polymel/chauffez-les-BEES-/Simon perso/Photos_Simon/montage carte, avec masque.jpg

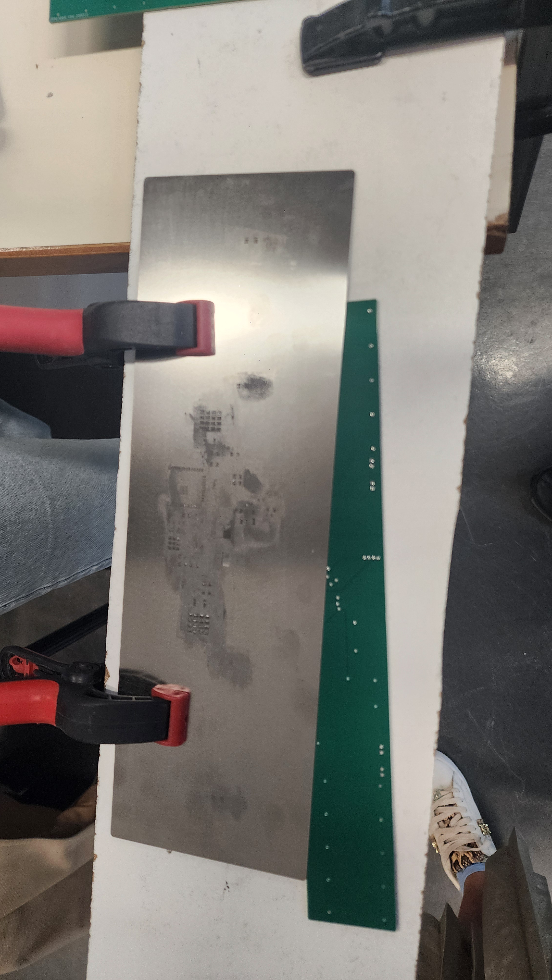
Simon perso/Photos_Simon/montage carte, avec masque.jpg
