polymel/chauffez-les-BEES-/Melilla perso/Montage téleversement.jpg

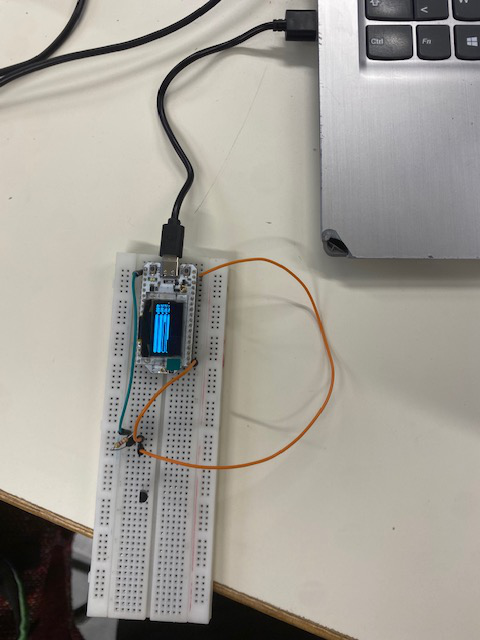
Melilla perso/Montage téleversement.jpg
