polymel/chauffez-les-BEES-/README.md

Ce reposit permet de regrouper les informations autour du projet d'électonique: réchauffement de ruche
consistant à réchauffer une ruche avec un stockage d'énergie thermique et un système électronique directement alimenté par un panneau solaire sans batterie
