polymel/chauffez-les-BEES-/Laura perso/Cahier de bord Projet Elec.pdf

Laura Boivin | ELSE4 23/09/2024

Cahier de bord

Où nous en étions :
La séance dernière nous avons étudié les objectifs du projet à travers la réalisation du cahier des charges (les destinataires du projet, les utilités, les contraintes du projet, coûts, les délais etc.). Projet qui s’étalera sur 9 mois comprenant des séances de 4h. Ce que nous avons fait cette séance :
Création du schéma électrique :

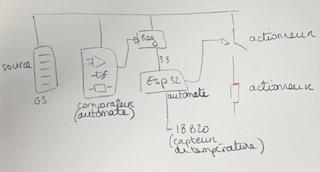
[picture p32: figure]

On a déterminé les différents composants nécessaires : une source d'énergie (un panneau solaire et un régulateur), un actionneur (résistances qui chauffent un interrupteur), un automate (ESP32 et le comparateur) et des capteurs (ici les DS18B20, pour mesurer la température de l'huile). On se sert d'une huile pour stocker l'énergie. Ce que nous ferons la séance prochaine :
On regardera comment faire le montage.
