polymel/chauffez-les-BEES-/Laura perso/IMG_9176.jpg

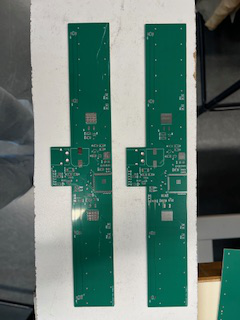
Laura perso/IMG_9176.jpg
