polymel/chauffez-les-BEES-/Laura perso/IMG_9178.jpg

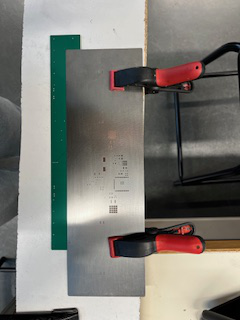
Laura perso/IMG_9178.jpg
