polymel/chauffez-les-BEES-/Laura perso/IMG_9179.jpg

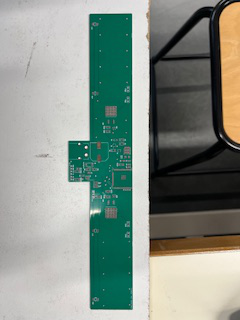
Laura perso/IMG_9179.jpg
