polymel/chauffez-les-BEES-/Laura perso/photo carte.jpg

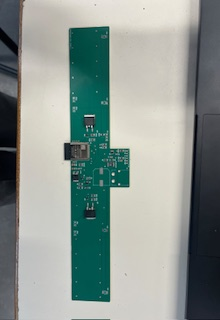
Laura perso/photo carte.jpg
