polymel/chauffez-les-BEES-/Laura perso/schema elec2.jpg

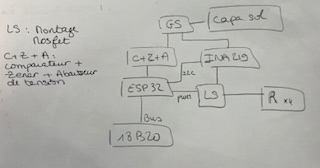
Laura perso/schema elec2.jpg
