polymel/chauffez-les-BEES-/Laura perso/schema elec.jpg

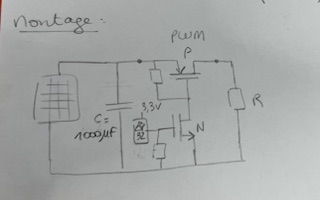
Laura perso/schema elec.jpg
