polymel/chauffez-les-BEES-/Melilla perso/Autotransfo.jpg

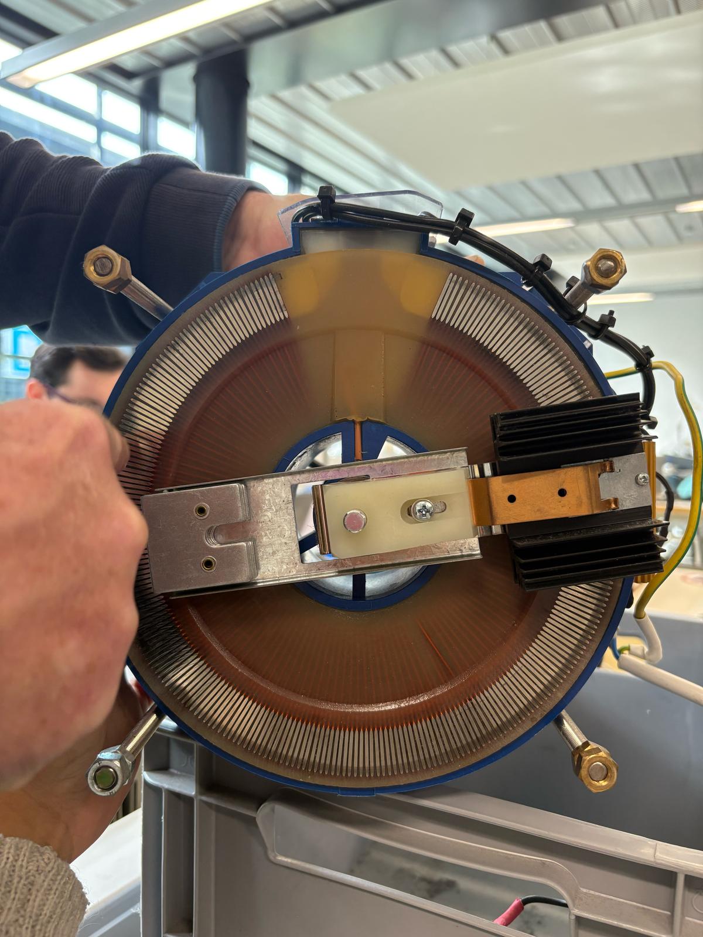
Melilla perso/Autotransfo.jpg
