polymel/chauffez-les-BEES-/Melilla perso/Branchement du capteur de température DS18B20.jpg

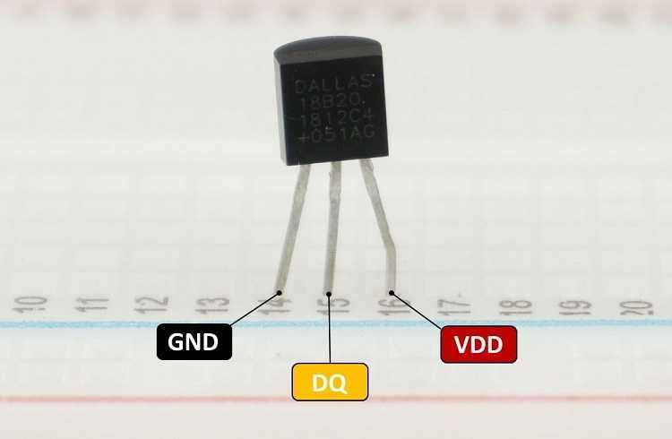
Melilla perso/Branchement du capteur de température DS18B20.jpg
