polymel/chauffez-les-BEES-/Melilla perso/Bête à corne Ruche.png

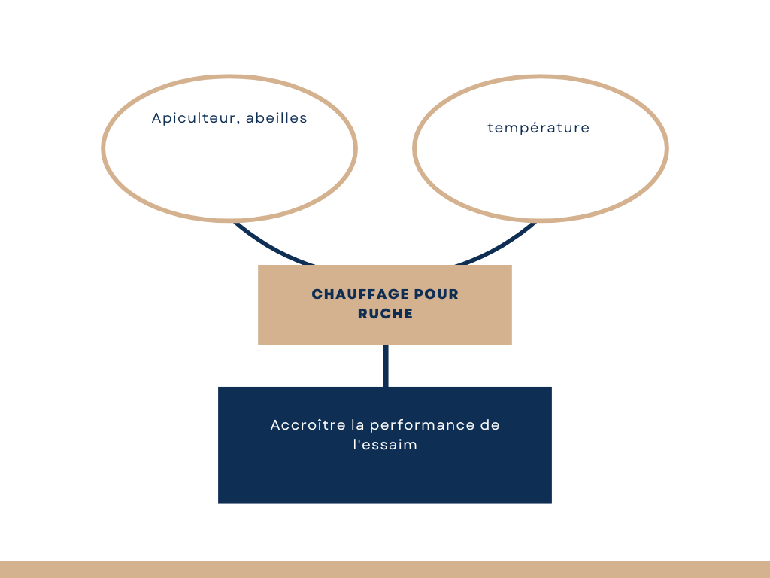
Melilla perso/Bête à corne Ruche.png
