polymel/chauffez-les-BEES-/Melilla perso/Compraison PCB avec et sans pâte à brasser.jpg

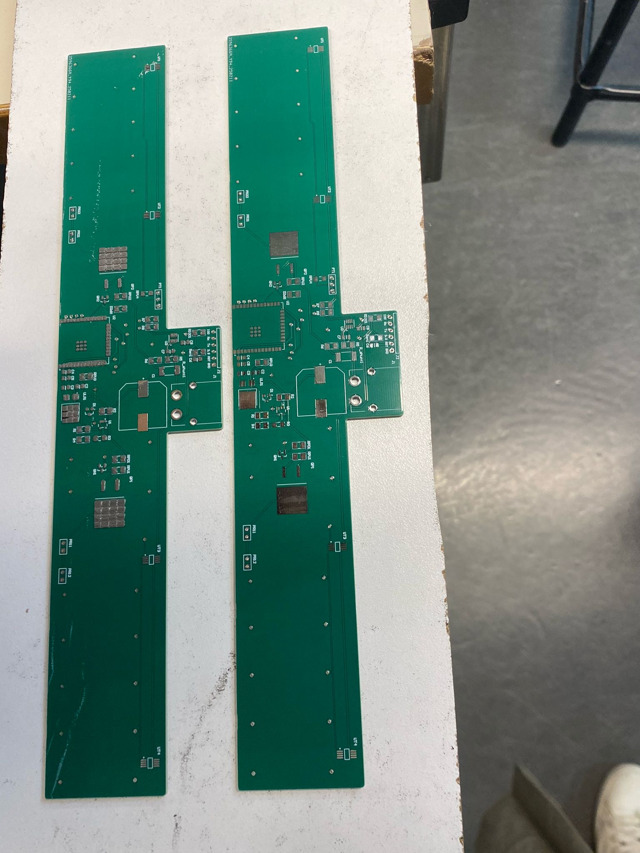
Melilla perso/Compraison PCB avec et sans pâte à brasser.jpg
