polymel/chauffez-les-BEES-/Melilla perso/connecteur RCA.jpeg

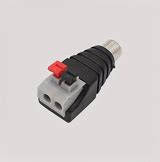
Melilla perso/connecteur RCA.jpeg
