polymel/chauffez-les-BEES-/Melilla perso/câblage de l'INA.jpg

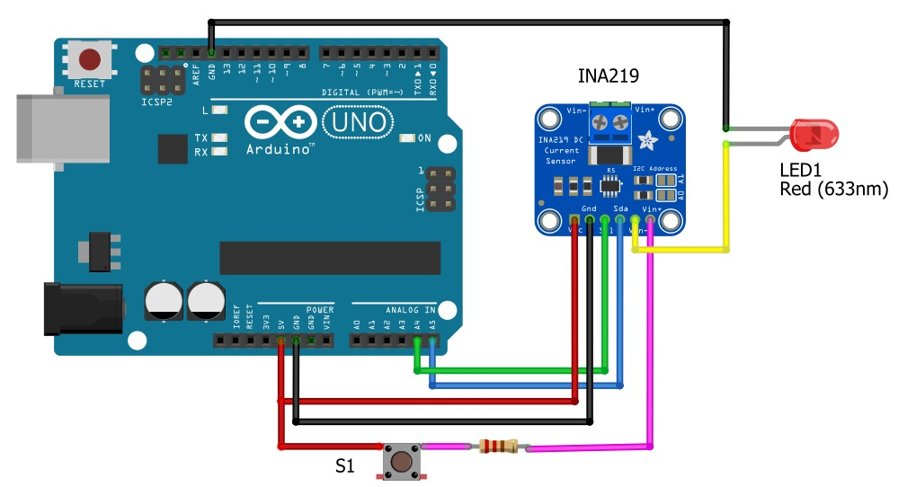
Melilla perso/câblage de l'INA.jpg
