polymel/chauffez-les-BEES-/Melilla perso/Diode zener valeurs standards.jpeg

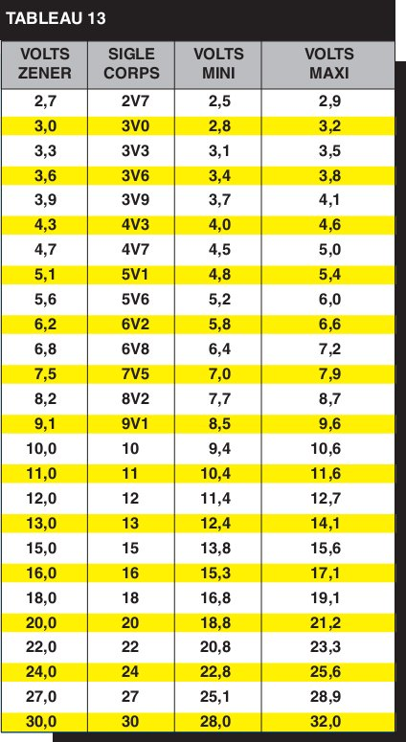
Melilla perso/Diode zener valeurs standards.jpeg
