polymel/chauffez-les-BEES-/Melilla perso/Détermination Ir2 .jpg

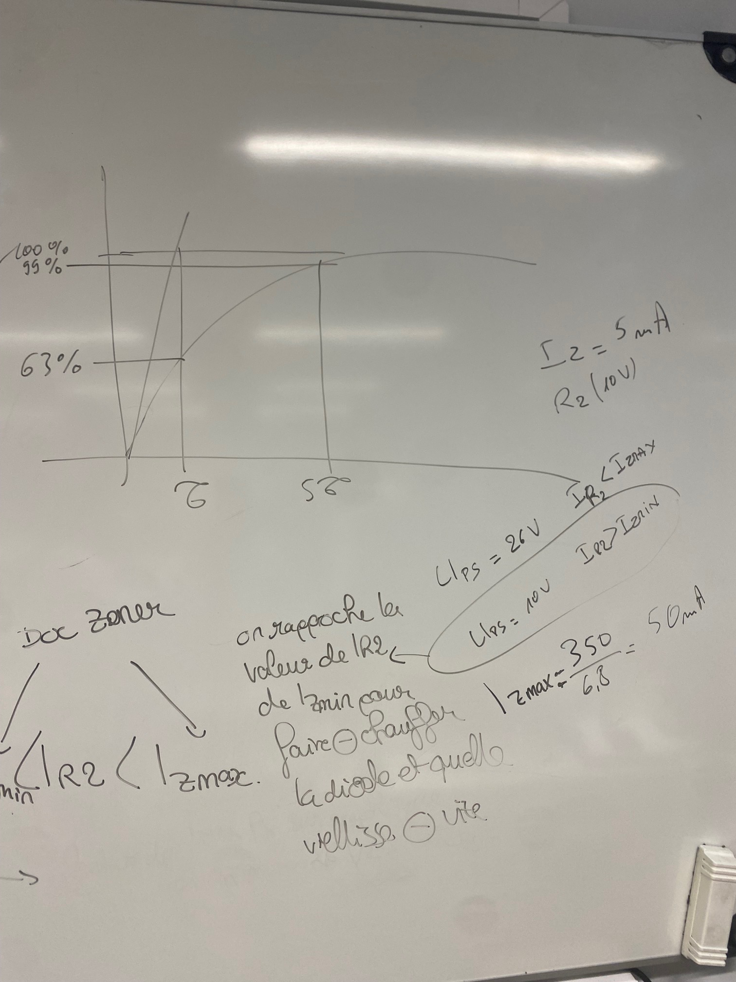
Melilla perso/Détermination Ir2 .jpg
