polymel/chauffez-les-BEES-/Melilla perso/Détrermoination R3 et R4 sans valeurs standards des résistances.png

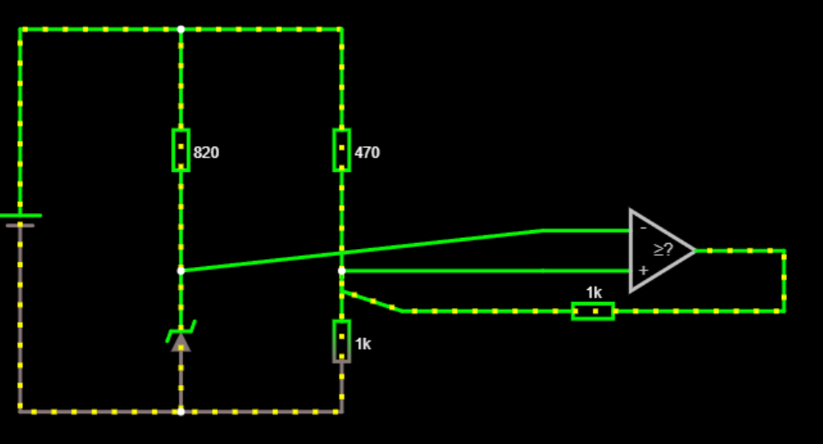
Melilla perso/Détrermoination R3 et R4 sans valeurs standards des résistances.png
