polymel/chauffez-les-BEES-/Melilla perso/four.jpg

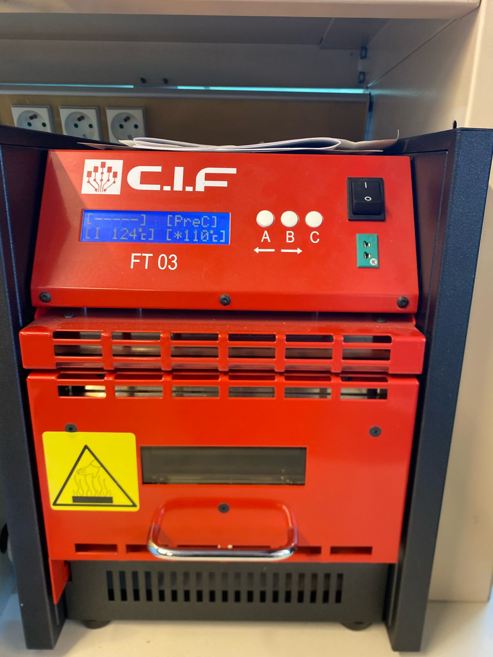
Melilla perso/four.jpg
