polymel/chauffez-les-BEES-/Melilla perso/graphique détermination Izmin.png

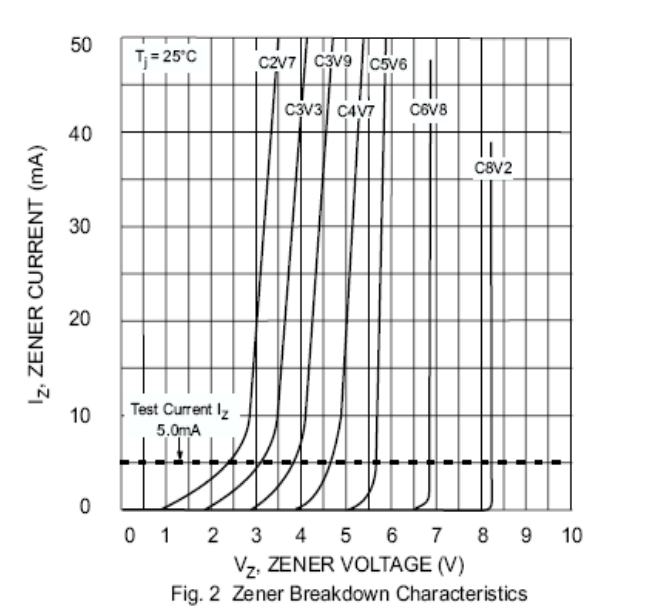
Melilla perso/graphique détermination Izmin.png
