polymel/chauffez-les-BEES-/Melilla perso/image.png

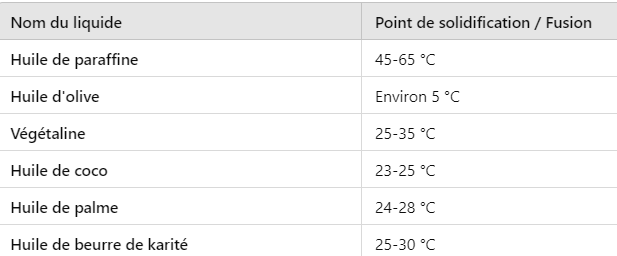
Melilla perso/image.png
