polymel/chauffez-les-BEES-/Melilla perso/influence de la température sur les mesures .jpg

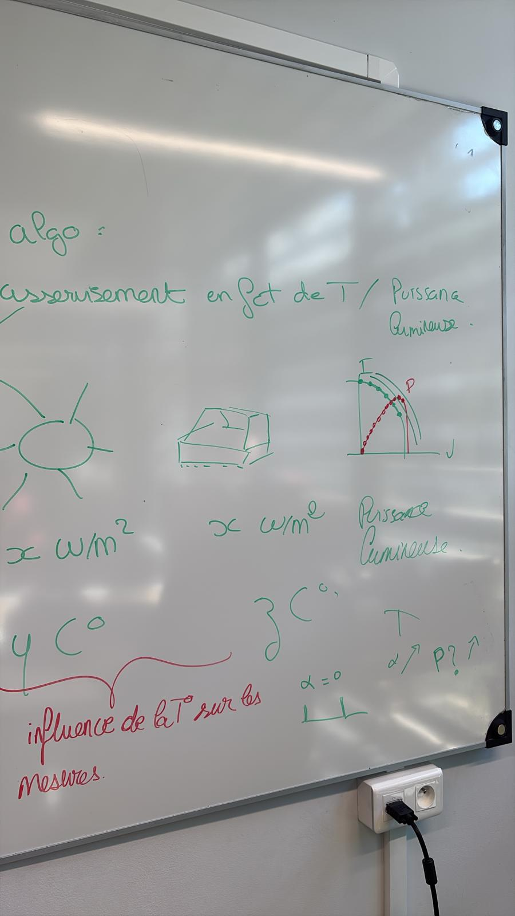
Melilla perso/influence de la température sur les mesures .jpg
