polymel/chauffez-les-BEES-/Melilla perso/inspection.jpg

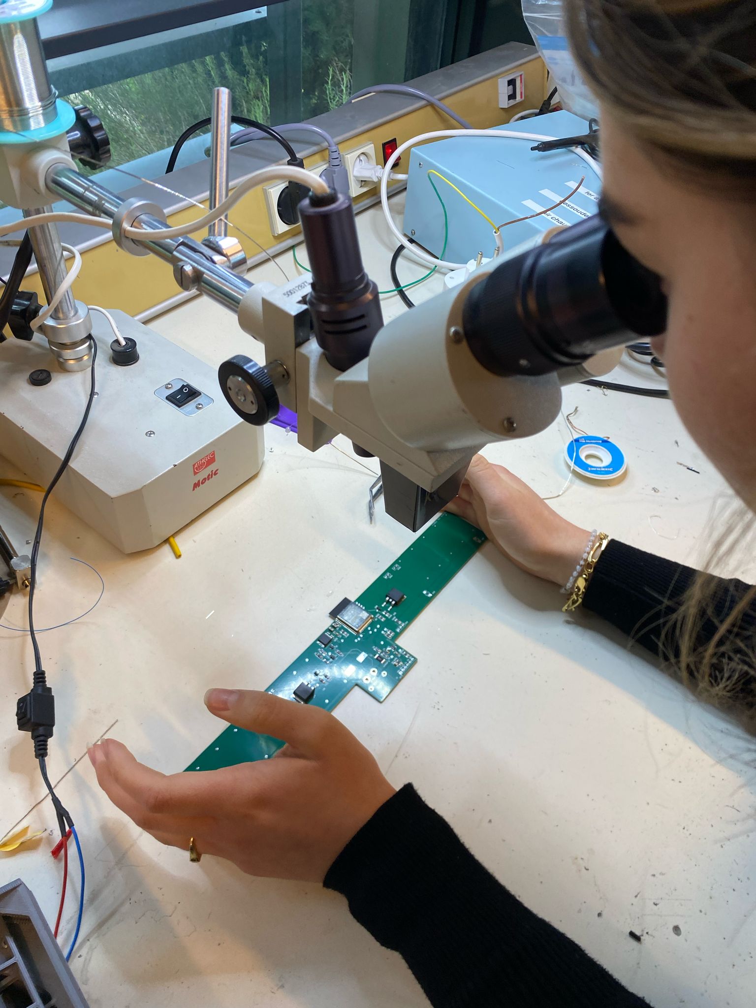
Melilla perso/inspection.jpg
