polymel/chauffez-les-BEES-/Melilla perso/masque - Copie.jpg

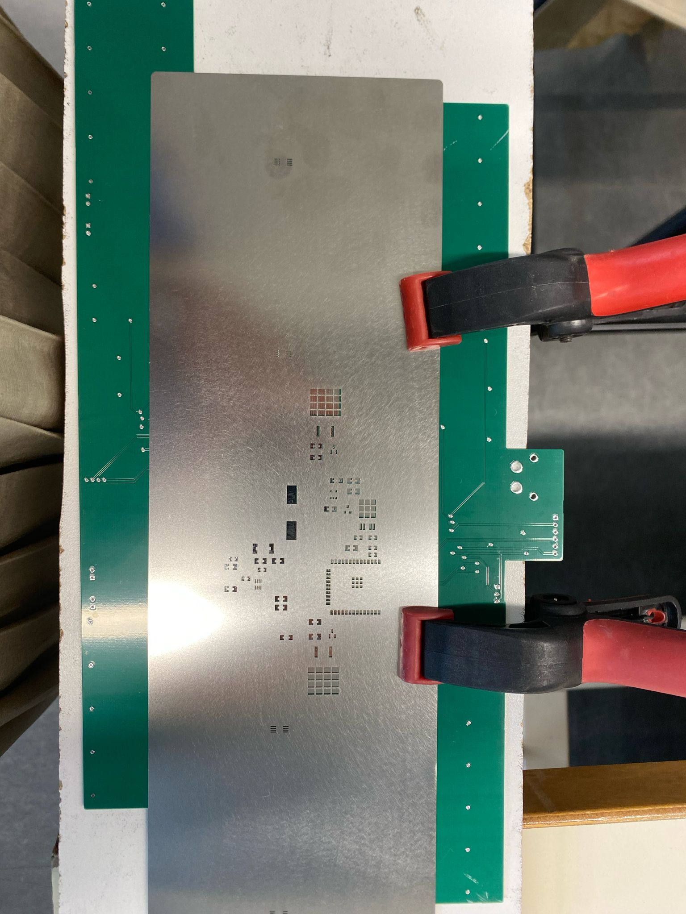
Melilla perso/masque - Copie.jpg
