polymel/chauffez-les-BEES-/Melilla perso/réflexion avant article .jpg

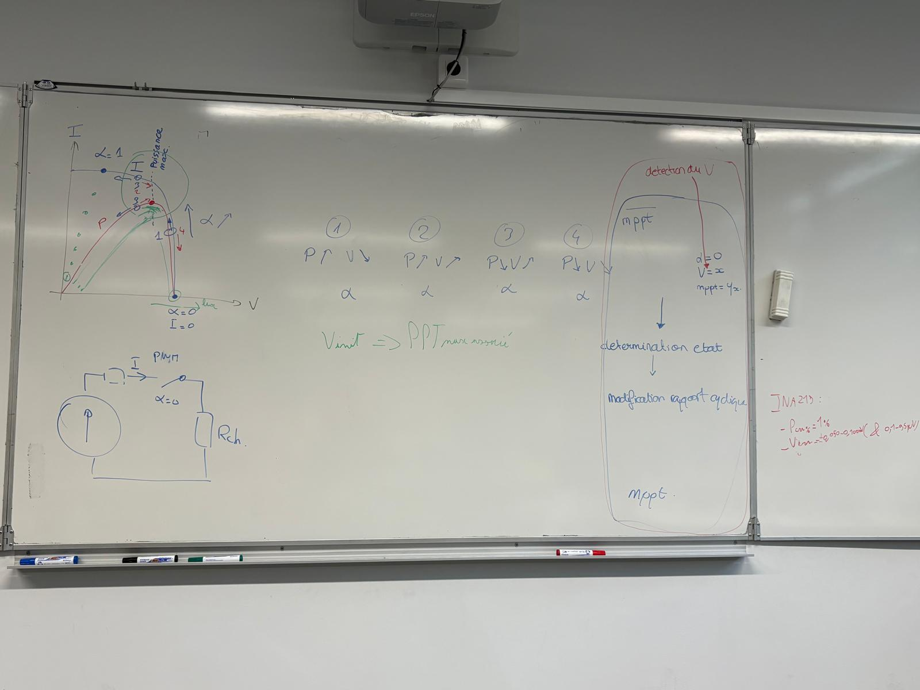
Melilla perso/réflexion avant article .jpg
