polymel/chauffez-les-BEES-/Melilla perso/Schémais alimentation de l'esp32 au panneau solaire.jpg

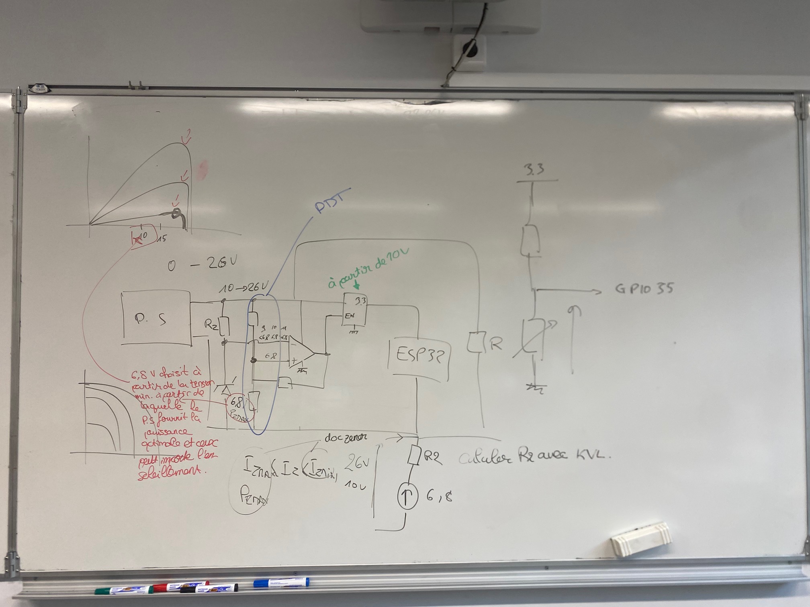
Melilla perso/Schémais alimentation de l'esp32 au panneau solaire.jpg
