polymel/chauffez-les-BEES-/Melilla perso/Schémas.jpg

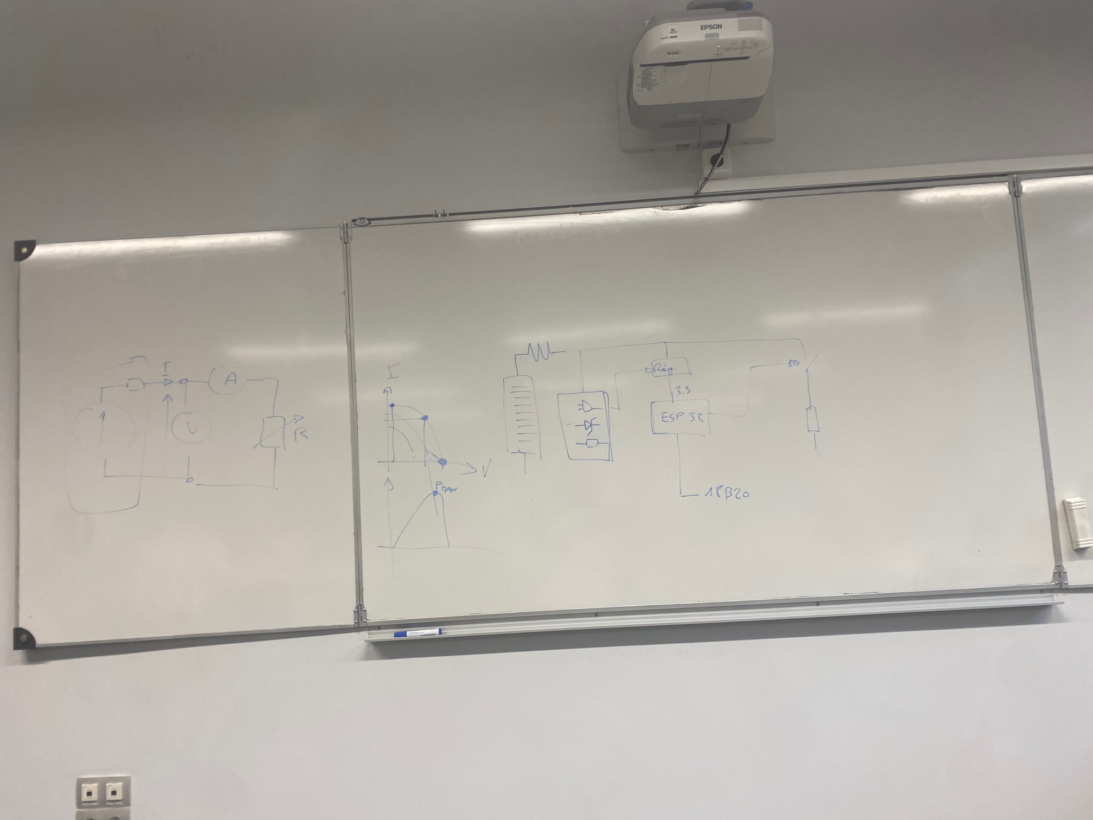
Melilla perso/Schémas.jpg
