polymel/chauffez-les-BEES-/Melilla perso/SImulation pour détermination de RAOP.jpg

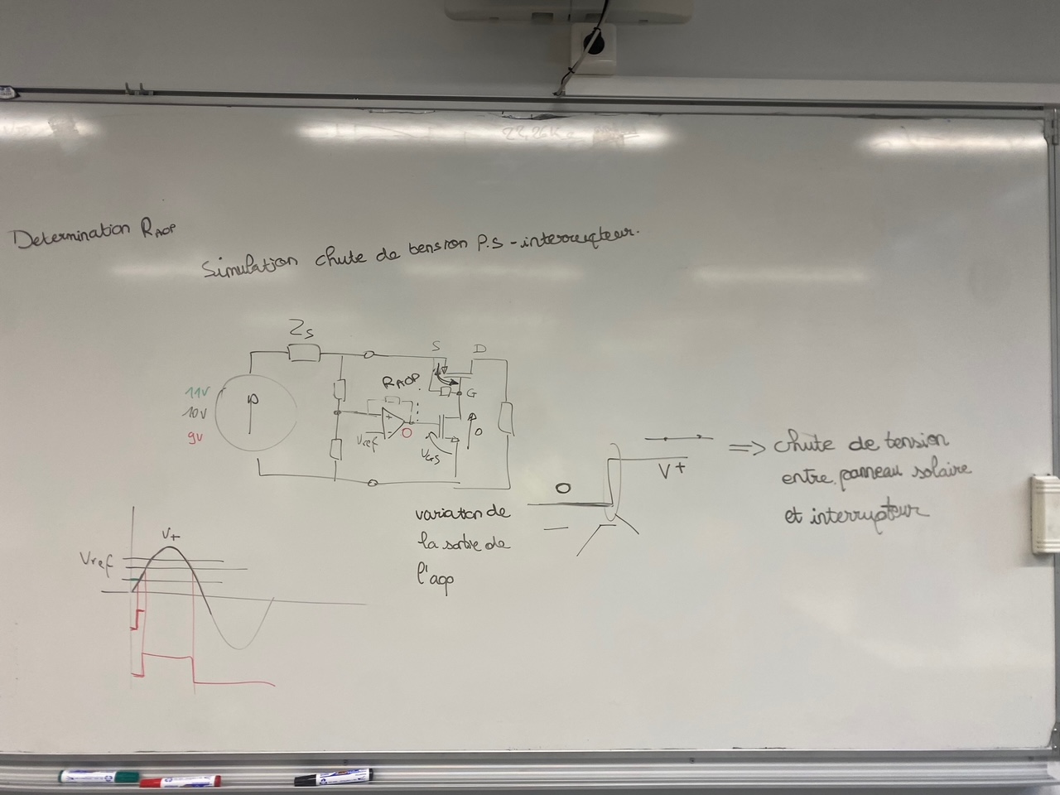
Melilla perso/SImulation pour détermination de RAOP.jpg
