polymel/chauffez-les-BEES-/Melilla perso/Target de Shmitt.jpg

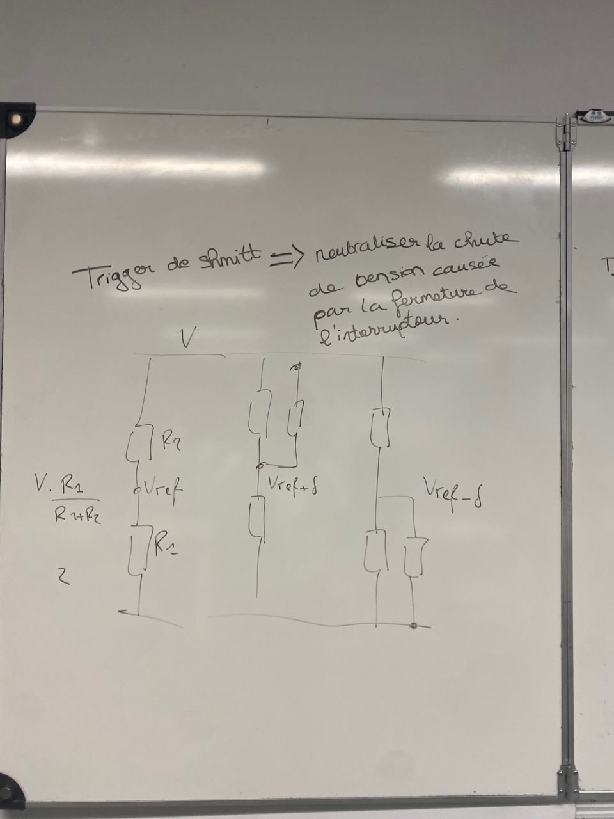
Melilla perso/Target de Shmitt.jpg
