polymel/chauffez-les-BEES-/Melilla perso/Tension en fct de la lumière sans charge.jpg

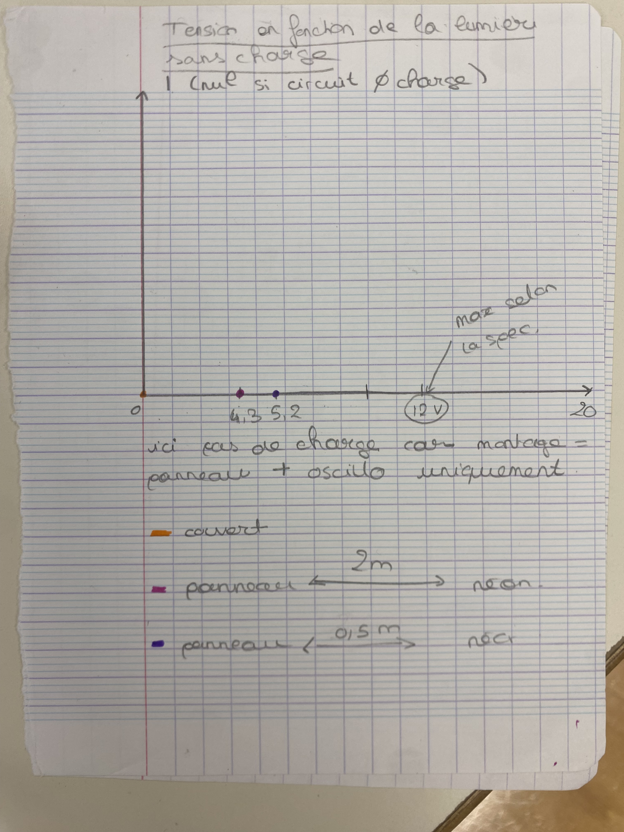
Melilla perso/Tension en fct de la lumière sans charge.jpg
