polymel/chauffez-les-BEES-/Melilla perso/UI puissance.png

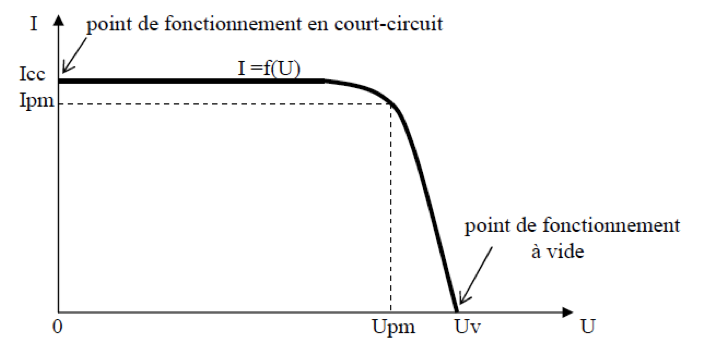
Melilla perso/UI puissance.png
