polymel/chauffez-les-BEES-/Melilla perso/Utilisation de l'article Conception d'un régulateur solaire avec commande MPPT.jpg

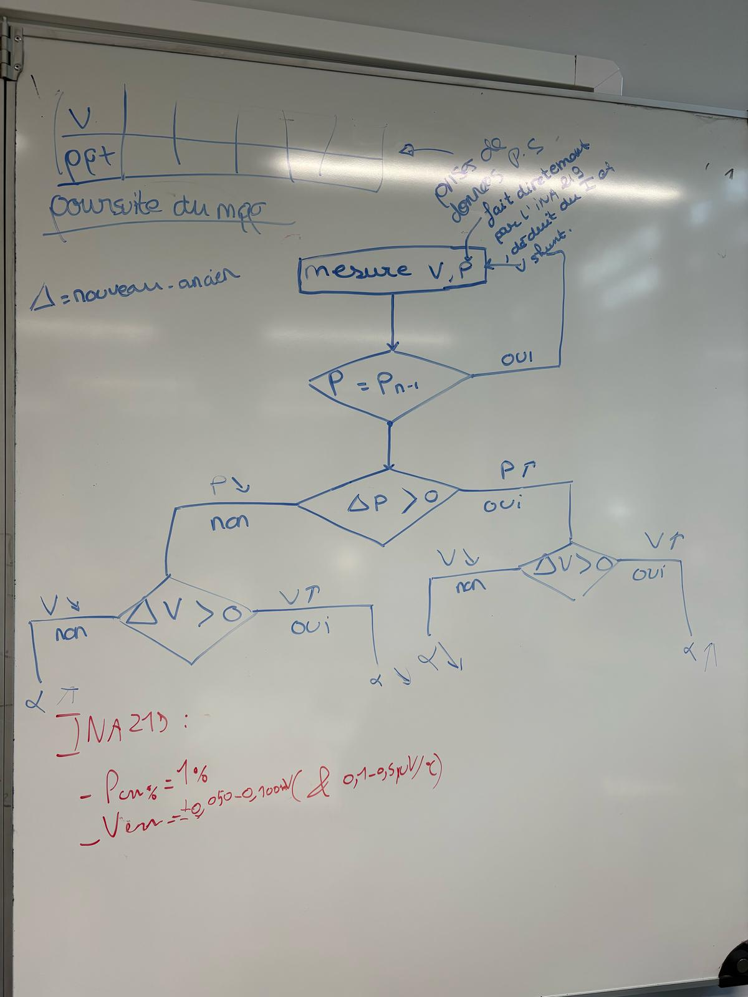
Melilla perso/Utilisation de l'article Conception d'un régulateur solaire avec commande MPPT.jpg
