polymel/chauffez-les-BEES-/Melilla perso/valeur  R2.jpeg

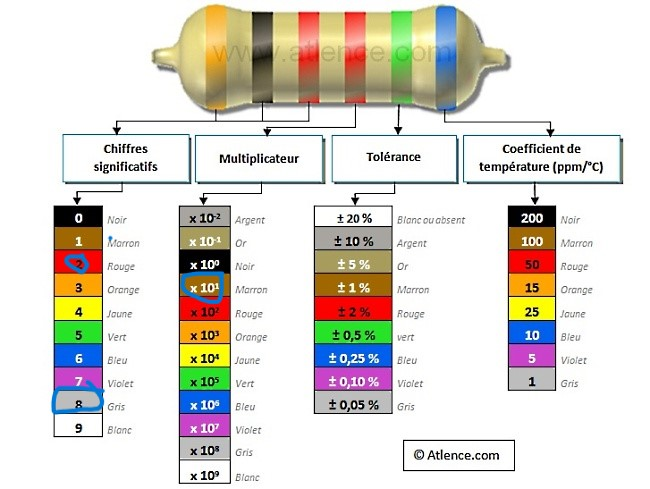
Melilla perso/valeur R2.jpeg
