polymel/chauffez-les-BEES-/Simon perso/log travail au 10_02_25 Simon sur le git.png

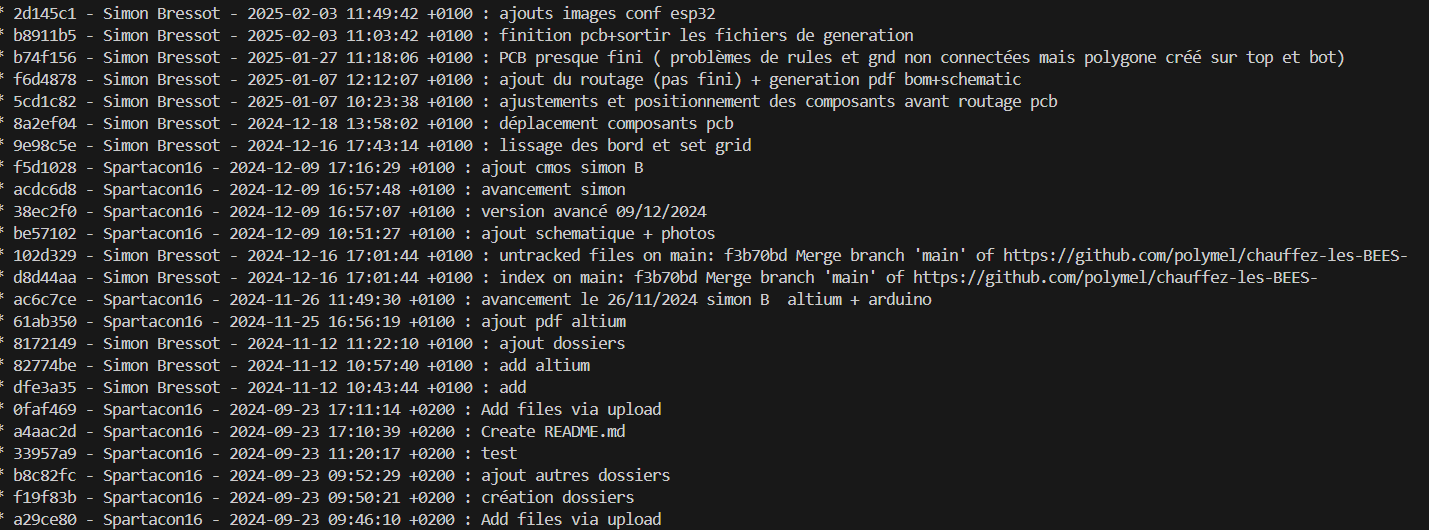
Simon perso/log travail au 10_02_25 Simon sur le git.png
