polymel/chauffez-les-BEES-/Simon perso/net étant dans la partie puissance Altium.png

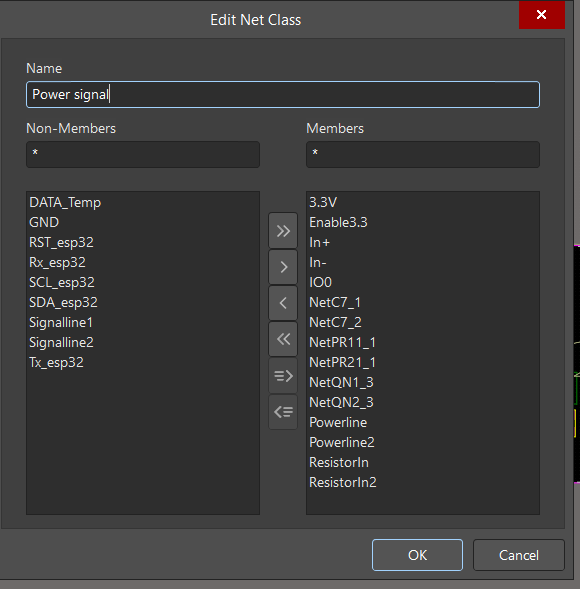
Simon perso/net étant dans la partie puissance Altium.png
