polymel/chauffez-les-BEES-/Simon perso/Photos_Simon/3D_view_Altium.jpg

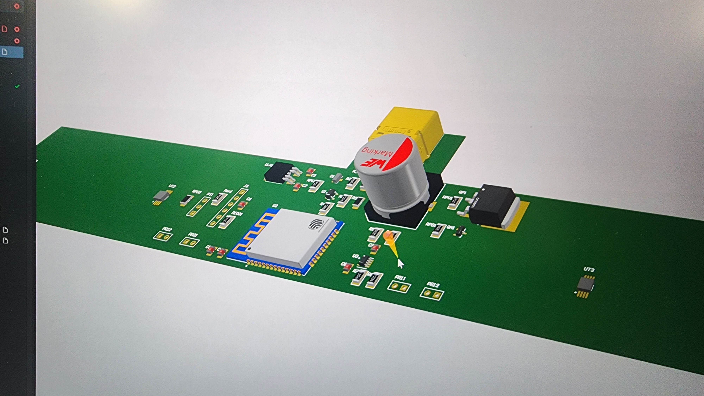
Simon perso/Photos_Simon/3D_view_Altium.jpg
