polymel/chauffez-les-BEES-/Simon perso/Photos_Simon/Caracteristiques_listées.jpg

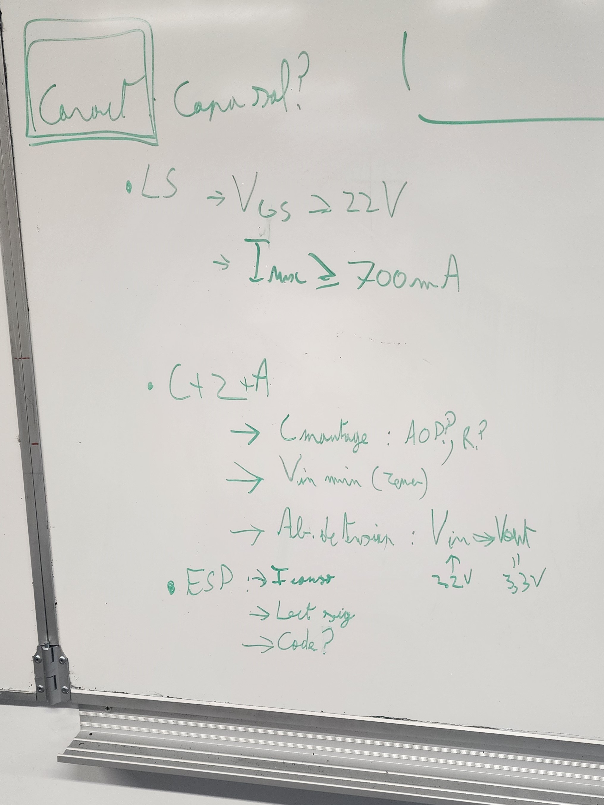
Simon perso/Photos_Simon/Caracteristiques_listées.jpg
