polymel/chauffez-les-BEES-/Simon perso/Photos_Simon/consomation esp 32.jpg

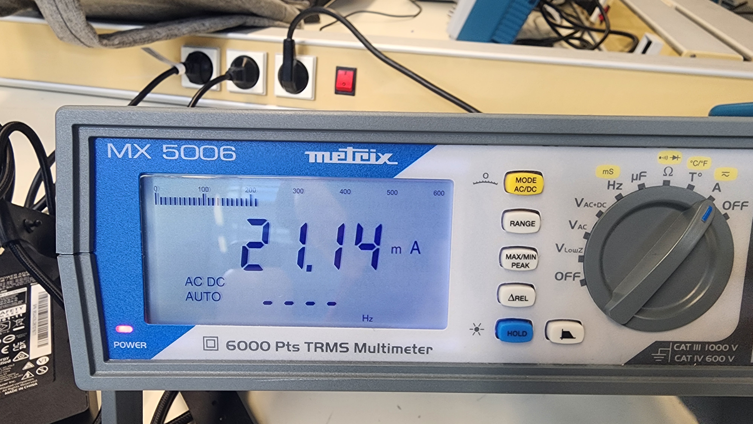
Simon perso/Photos_Simon/consomation esp 32.jpg
