polymel/chauffez-les-BEES-/Simon perso/Photos_Simon/esp32 pin_sous_composant.jpg

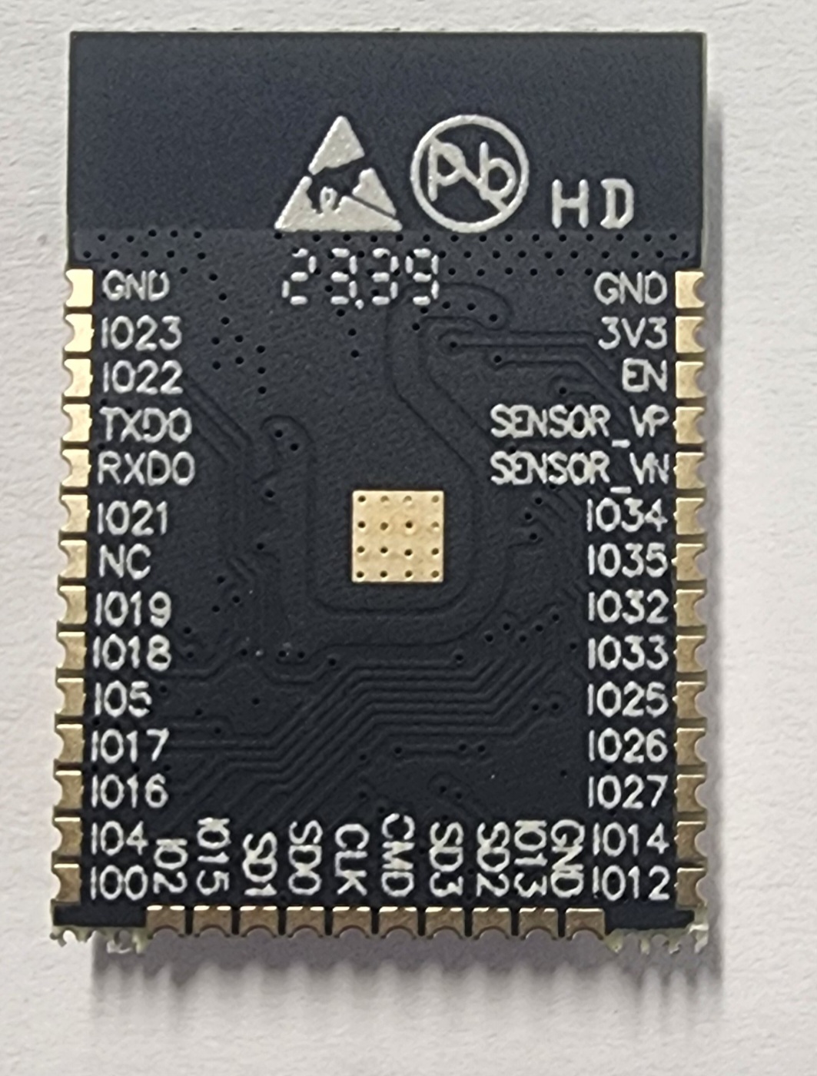
Simon perso/Photos_Simon/esp32 pin_sous_composant.jpg
