polymel/chauffez-les-BEES-/Simon perso/Photos_Simon/four à fusion.jpg

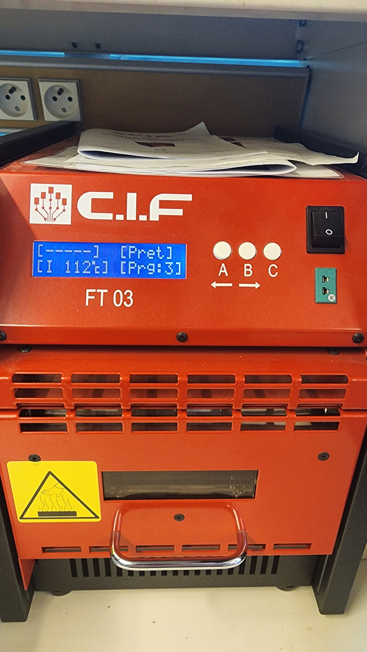
Simon perso/Photos_Simon/four à fusion.jpg
