polymel/chauffez-les-BEES-/Simon perso/Photos_Simon/IMG-20241209-WA0001.jpg

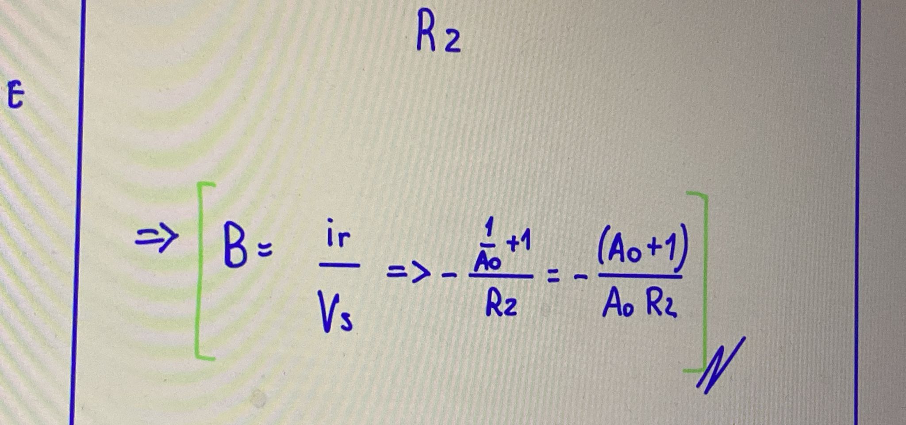
Simon perso/Photos_Simon/IMG-20241209-WA0001.jpg
