polymel/chauffez-les-BEES-/Simon perso/Photos_Simon/liste_des_taches&schema_bloc_du_circuit.png

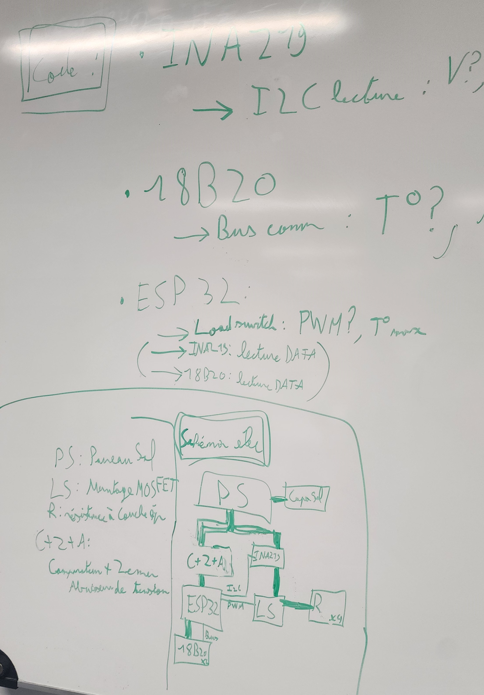
Simon perso/Photos_Simon/liste_des_taches&schema_bloc_du_circuit.png
