polymel/chauffez-les-BEES-/Simon perso/Photos_Simon/Log_esp32 sur arduino.jpg

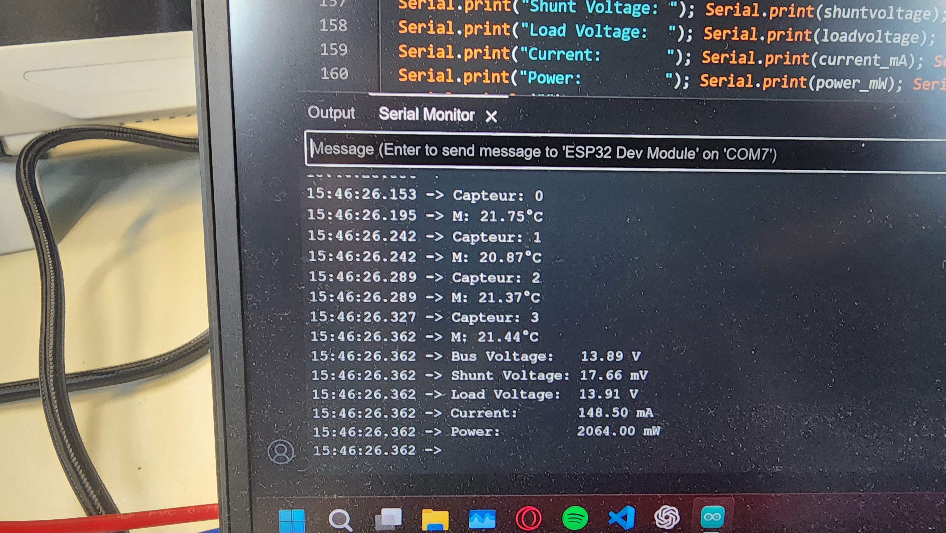
Simon perso/Photos_Simon/Log_esp32 sur arduino.jpg
