polymel/chauffez-les-BEES-/Simon perso/Photos_Simon/pcb après le four à fusion.jpg

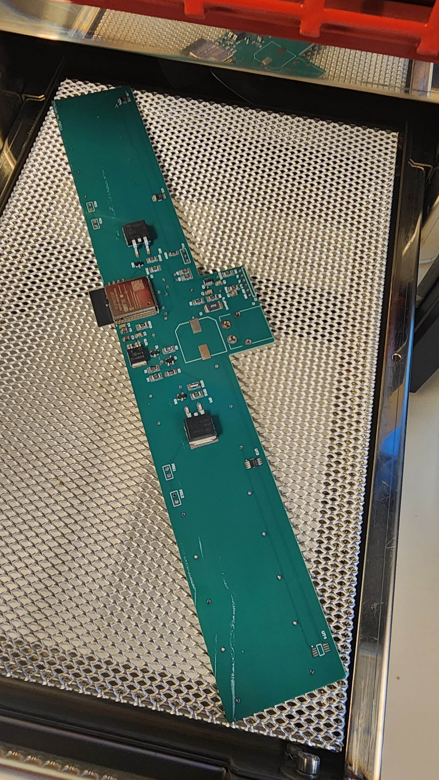
Simon perso/Photos_Simon/pcb après le four à fusion.jpg
