polymel/chauffez-les-BEES-/Simon perso/Photos_Simon/pcb branché avec connexion via uart sur pc.jpg

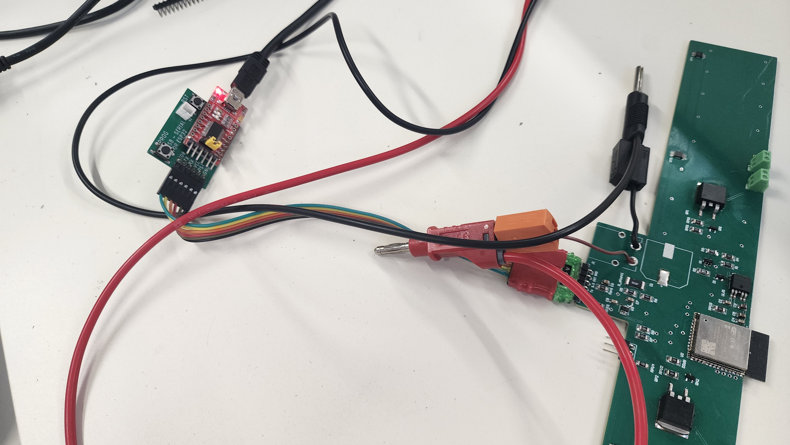
Simon perso/Photos_Simon/pcb branché avec connexion via uart sur pc.jpg
