polymel/chauffez-les-BEES-/Simon perso/Photos_Simon/pcb branché.jpg

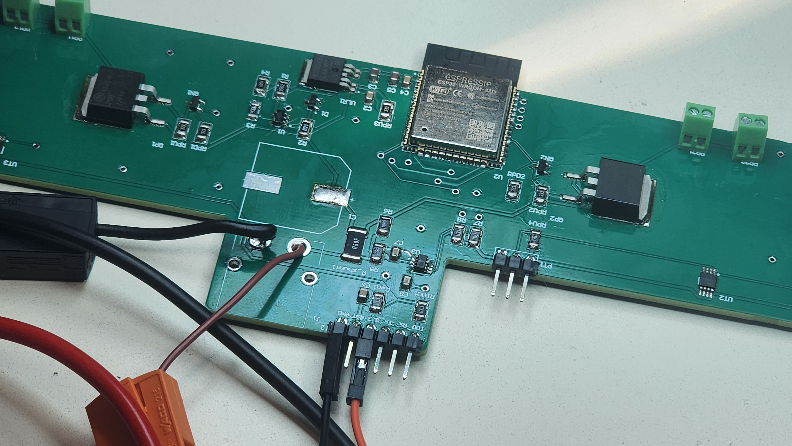
Simon perso/Photos_Simon/pcb branché.jpg
