polymel/chauffez-les-BEES-/Simon perso/Photos_Simon/pcb dans le four à fusion.jpg

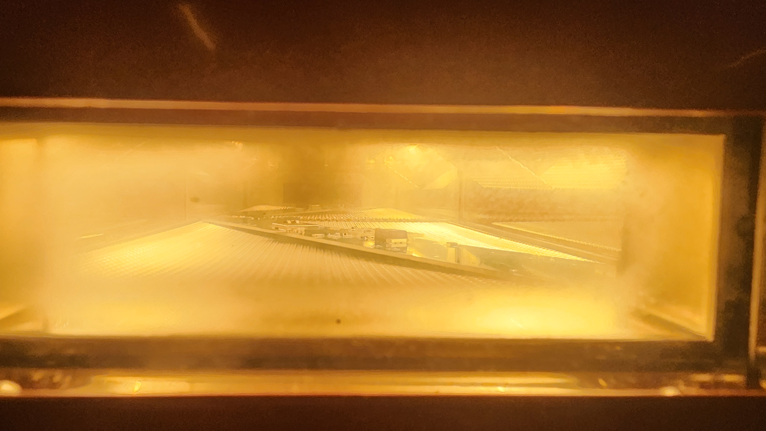
Simon perso/Photos_Simon/pcb dans le four à fusion.jpg
