polymel/chauffez-les-BEES-/Simon perso/Photos_Simon/pcb modification pin DATA Temps de 12 à14.jpg

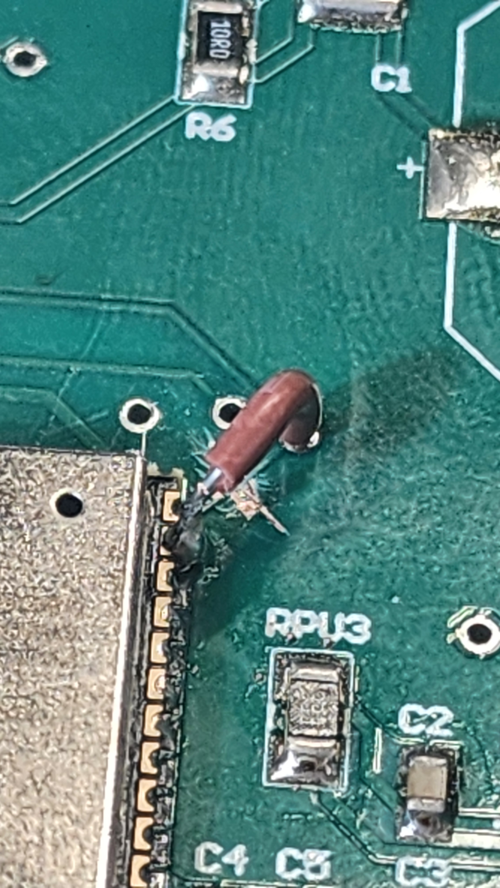
Simon perso/Photos_Simon/pcb modification pin DATA Temps de 12 à14.jpg
