polymel/chauffez-les-BEES-/Simon perso/Photos_Simon/pcb zoom sur U3.jpg

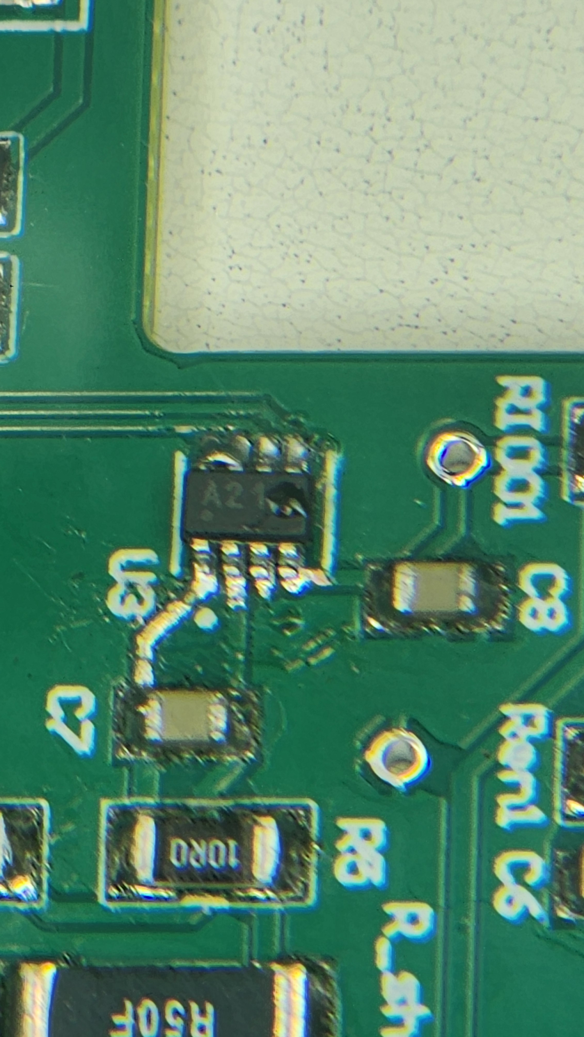
Simon perso/Photos_Simon/pcb zoom sur U3.jpg
