polymel/chauffez-les-BEES-/Simon perso/Photos_Simon/pcb à la binocle(zoom sur esp32 et son alim).jpg

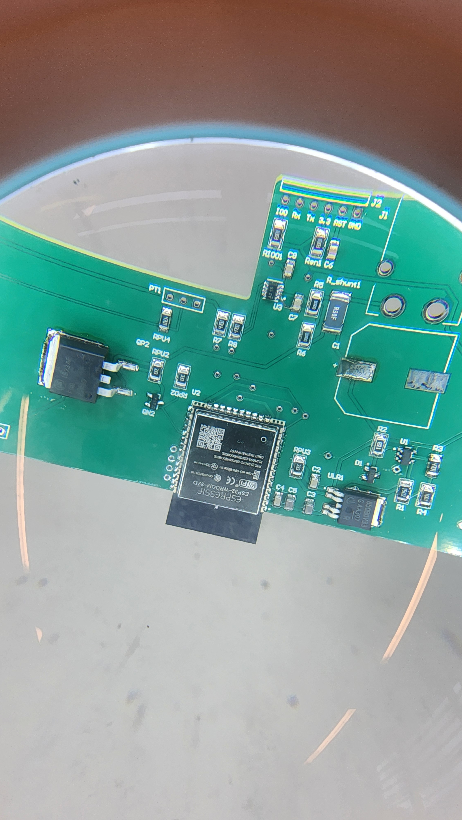
Simon perso/Photos_Simon/pcb à la binocle(zoom sur esp32 et son alim).jpg
