polymel/chauffez-les-BEES-/Simon perso/pin_map_heltec_V3.jpg

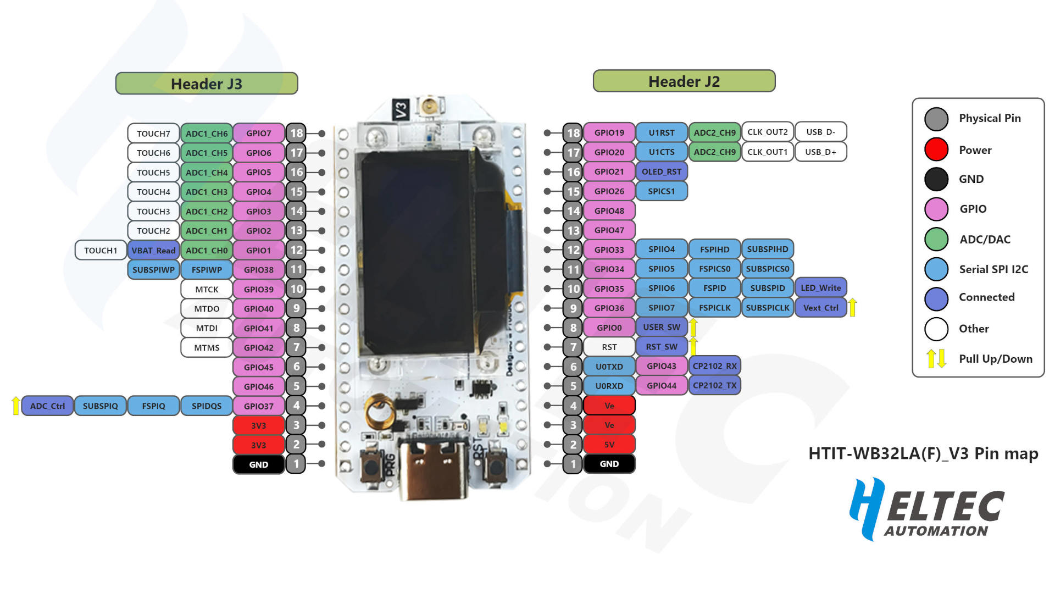
Simon perso/pin_map_heltec_V3.jpg
