polymel/chauffez-les-BEES-/Simon perso/pin_map_pcb.png

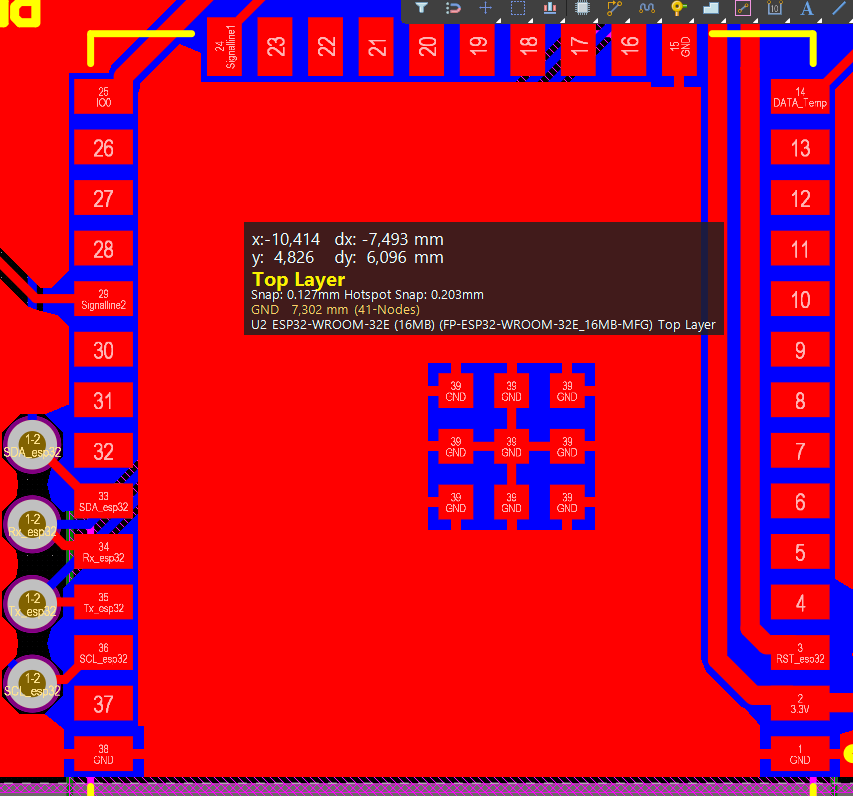
Simon perso/pin_map_pcb.png
