polymel/chauffez-les-BEES-/Simon perso/Screenshot_Simon/liste_esp_32_attribue_initial_Altium.png

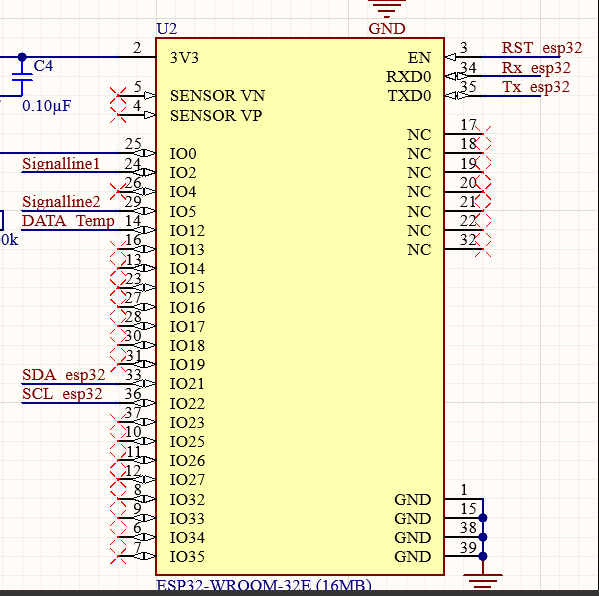
Simon perso/Screenshot_Simon/liste_esp_32_attribue_initial_Altium.png
