polymel/chauffez-les-BEES-/Simon perso/Screenshot_Simon/Log_INA219+TEMP_2sensors_teraterm.png

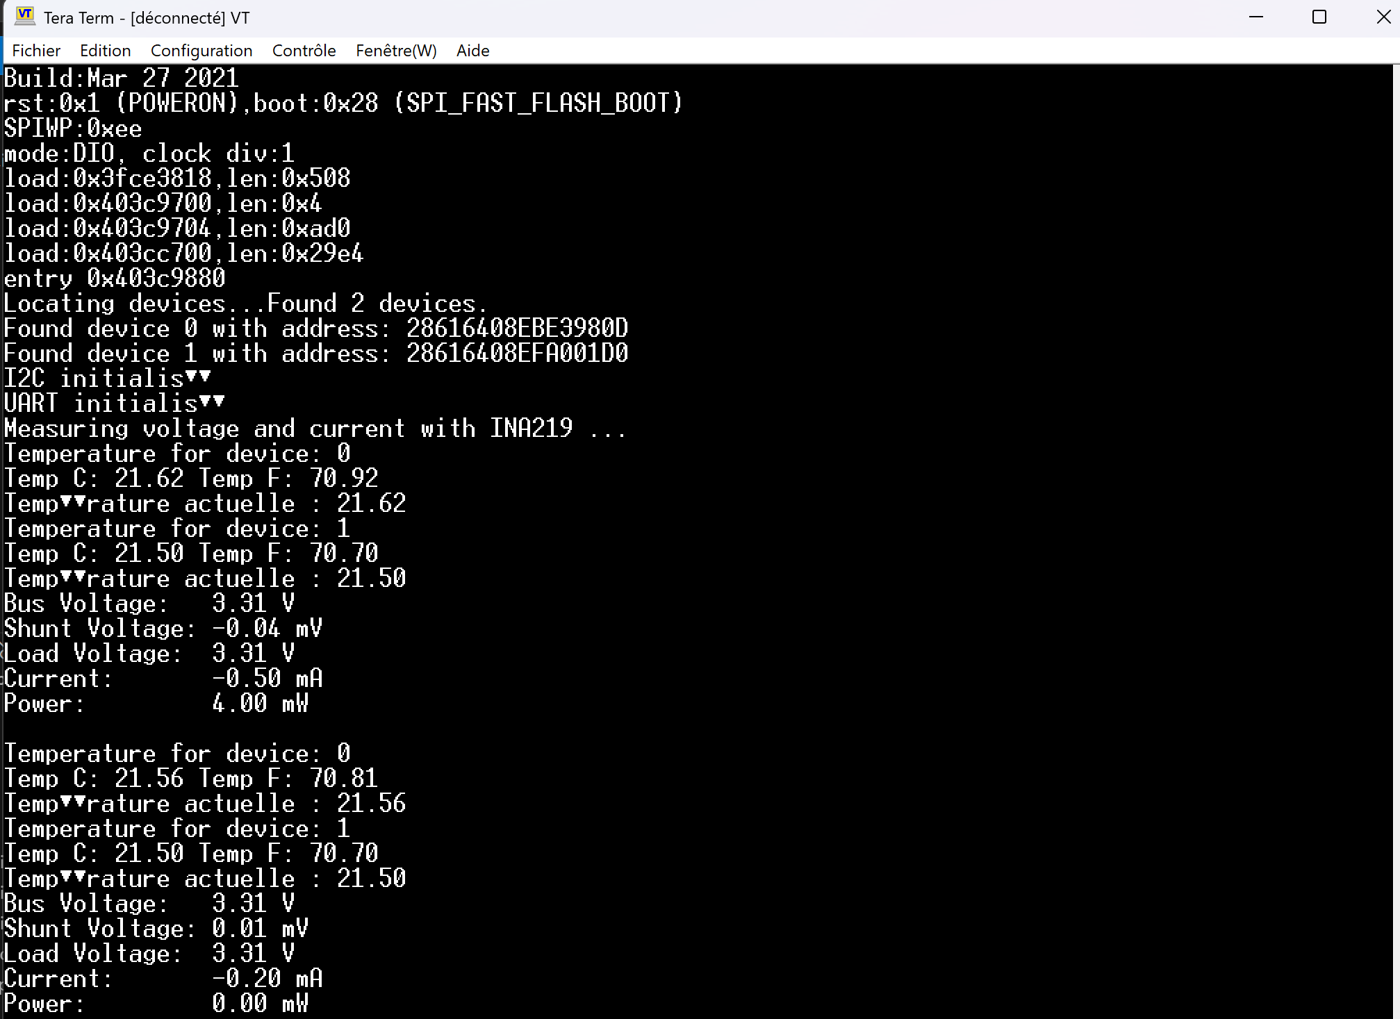
Simon perso/Screenshot_Simon/Log_INA219+TEMP_2sensors_teraterm.png
