polymel/chauffez-les-BEES-/Simon perso/Screenshot_Simon/Page html d'affichage des donées via wifi direct.png

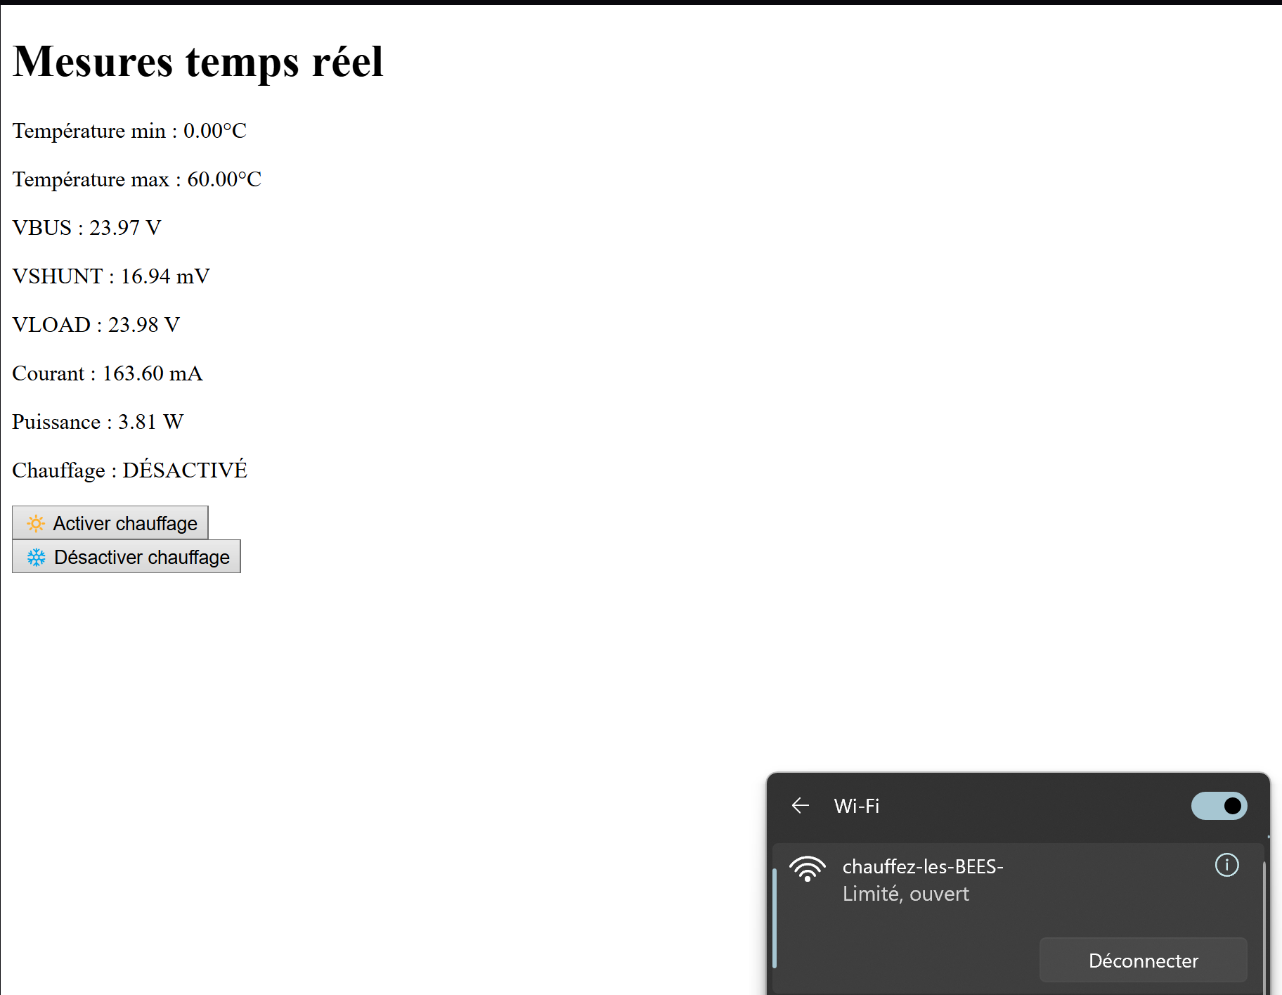
Simon perso/Screenshot_Simon/Page html d'affichage des donées via wifi direct.png
