polymel/chauffez-les-BEES-/Laura perso/Recap composant.xlsx

Tableau récapitulatif des composants
Nom | Valeur | Reference
D zener (V) | 6.8
R3 | 4700 | -
R4 | 10000 | -
R2 | 820 | -
AOP | - | AP331A
ESP32 | - | ESP32 WROOM
Capteurs deTemp° | - | 18B20
Raop | 15K
