polymel/chauffez-les-BEES-/Laura perso/Montage GS.jpg

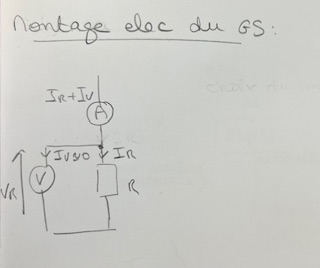
Laura perso/Montage GS.jpg
