polymel/chauffez-les-BEES-/Melilla perso/choix montage ampèrmetre .jpg

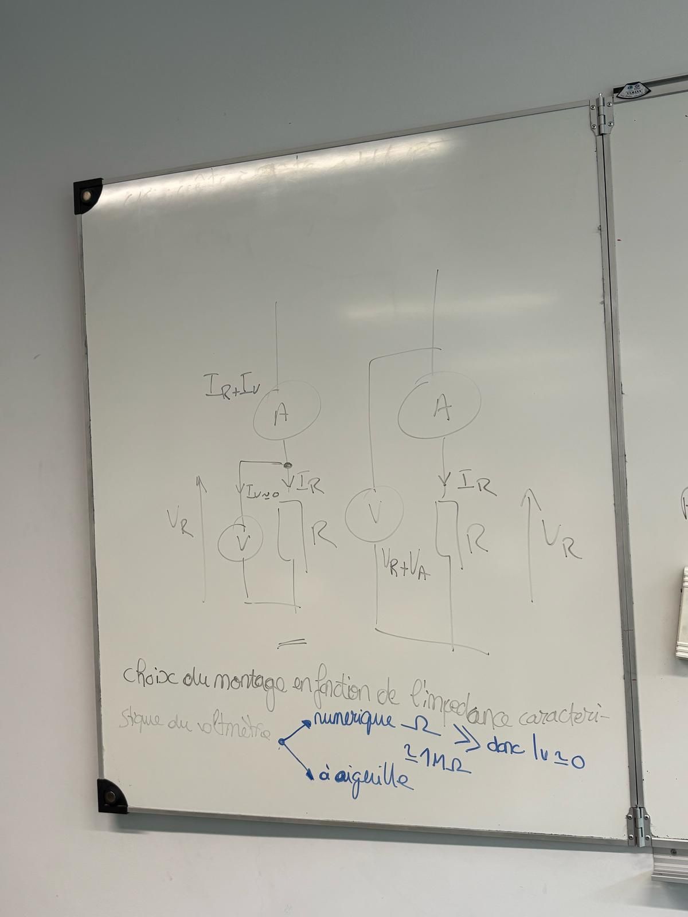
Melilla perso/choix montage ampèrmetre .jpg
