polymel/chauffez-les-BEES-/Melilla perso/Montage avec INA 219 et final.jpg

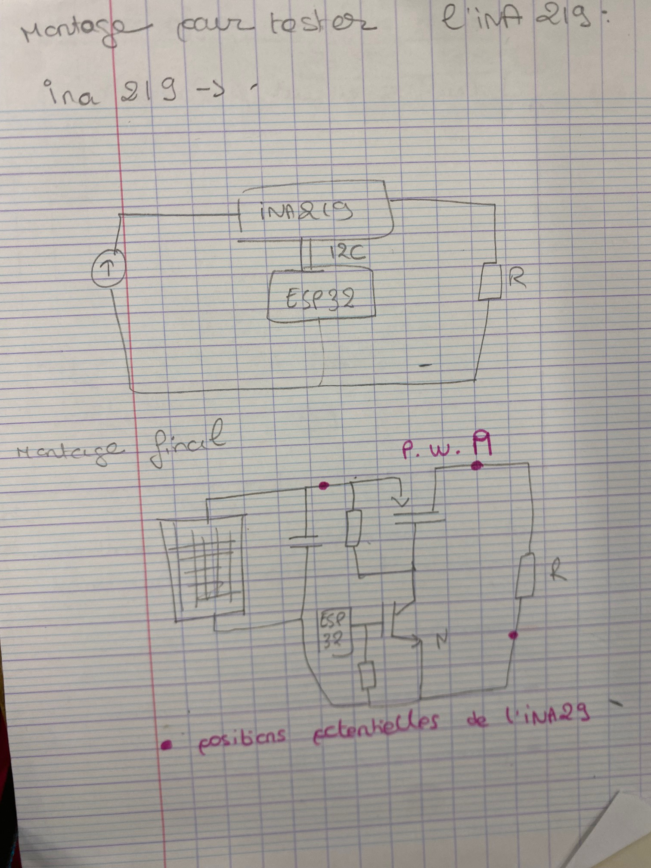
Melilla perso/Montage avec INA 219 et final.jpg
