polymel/chauffez-les-BEES-/Melilla perso/Montage couvert.jpg

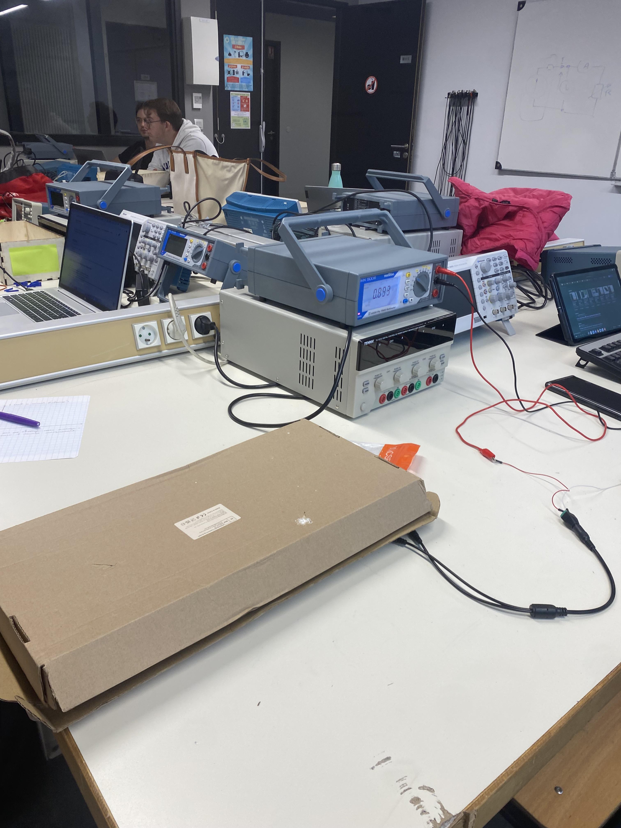
Melilla perso/Montage couvert.jpg
