polymel/chauffez-les-BEES-/Melilla perso/Montage essai code poursuite mppt.jpg

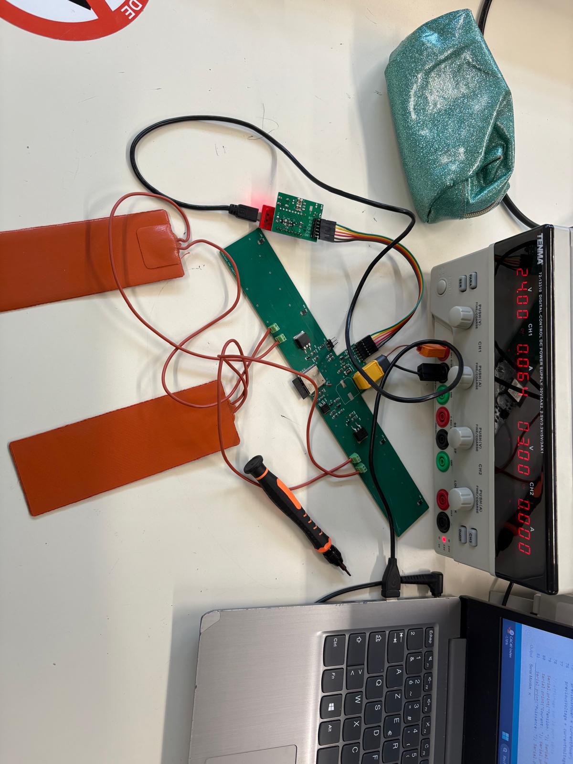
Melilla perso/Montage essai code poursuite mppt.jpg
