polymel/chauffez-les-BEES-/Melilla perso/Montage mesure caractéristique panneau solaire .jpg

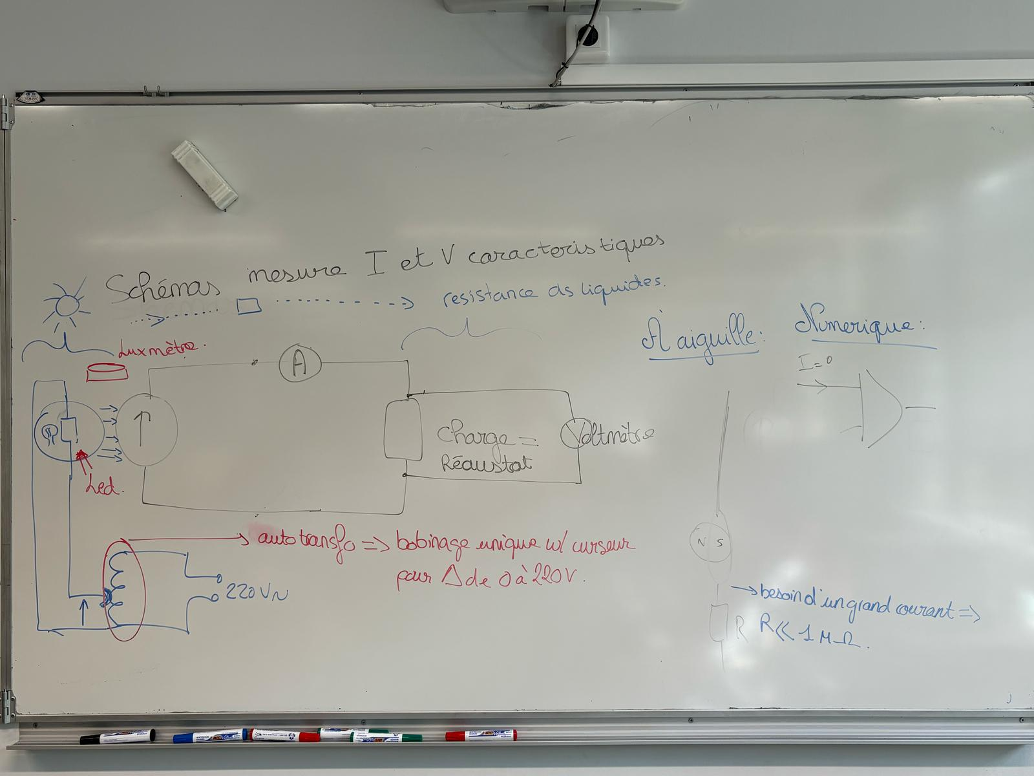
Melilla perso/Montage mesure caractéristique panneau solaire .jpg
