polymel/chauffez-les-BEES-/Melilla perso/Montage non couvert distance 2M.jpg

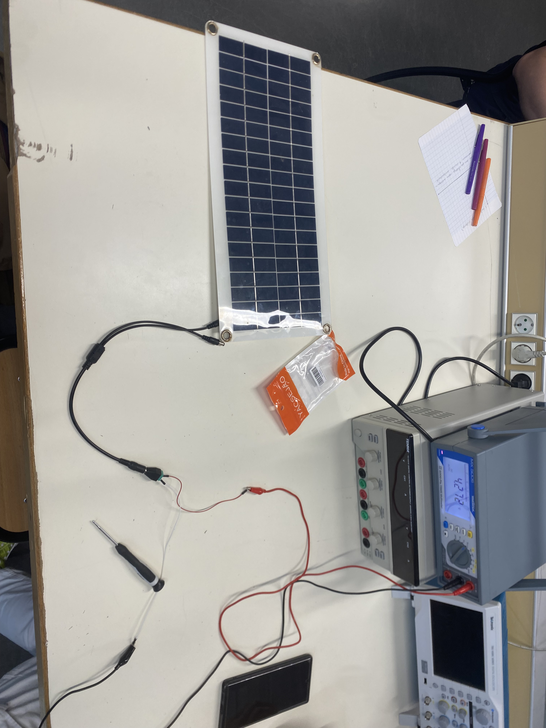
Melilla perso/Montage non couvert distance 2M.jpg
