polymel/chauffez-les-BEES-/Melilla perso/Montage physique .jpg

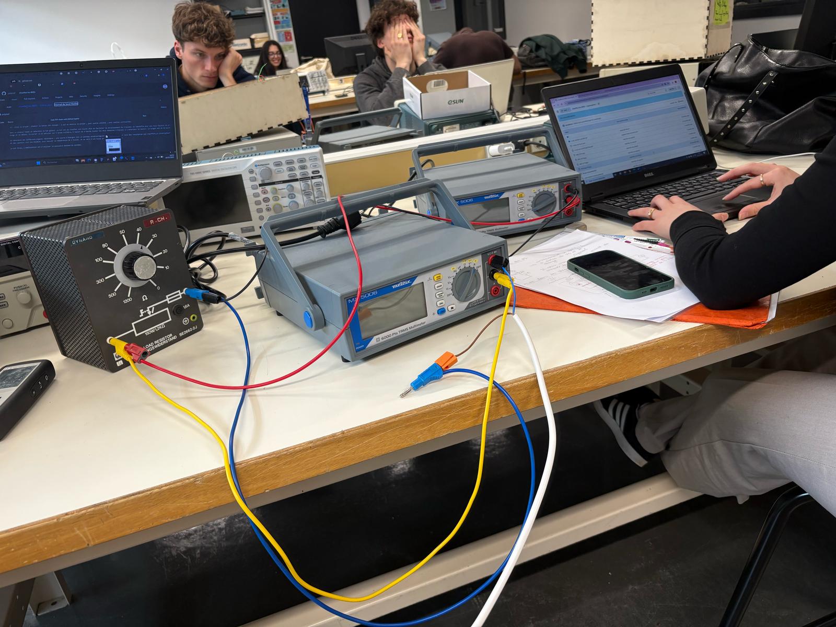
Melilla perso/Montage physique .jpg
