polymel/chauffez-les-BEES-/(list of files, drawings)

Other design files:
Altium_PCB/Altium_PCB.PrjPcb
Altium_PCB/PCB_bee.PcbDoc
Altium_PCB/Sheet_BEEE.SchDoc
