polymel/chauffez-les-BEES-/(commit log)

2024-09-23 Update Journal de bord Melilla
2024-09-23 Add files via upload
    add rapport de séance
2024-11-12 Update Journal de bord Melilla
    essai
2024-11-12 Add files via upload
    doc prof
    [P_panneau_solaire.ods]
2024-11-12 Update Cahier de bord
2024-11-12 Rename note to Cahier de Bord suivi
2024-11-12 Update Cahier de Bord suivi
2024-11-12 Create Code arduino premier jet
2024-11-12 ajout dossiers
    [Sheet_BEEE.SchDoc]
2024-11-25 Create Code ESP32.CaptT
2024-11-26 avancement le 26/11/2024 simon B altium + arduino
    [Sheet_BEEE.SchDoc]
2024-12-09 version plus avancé avant création pcb
    [Altium_PCB.PrjPcb, Sheet_BEEE.SchDoc]
2024-12-09 version avancé 09/12/2024
    [Altium_PCB.PrjPcb, PCB_bee.PcbDoc, Sheet_BEEE.SchDoc]
2024-12-09 ajout cmos simon B
    [PCB_bee.PcbDoc, Sheet_BEEE.SchDoc]
2024-12-16 lissage des bord et set grid
    [PCB_bee.PcbDoc]
2024-12-18 déplacement composants pcb
    [PCB_bee.PcbDoc]
2025-01-07 ajustements et positionnement des composants avant routage pcb
    [PCB_bee.PcbDoc, Sheet_BEEE.SchDoc]
2025-01-07 Update Cahier de Bord suivi*
2025-01-07 ajout du routage (pas fini) + generation pdf bom+schematic
    [Altium_PCB.PrjPcb, PCB_bee.PcbDoc]
2025-01-27 PCB presque fini ( problèmes de rules et gnd non connectées mais polygone créé sur top et bot)
    [PCB_bee.PcbDoc]
2025-02-03 finition pcb+sortir les fichiers de generation
    [Altium_PCB.PrjPcb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]
2025-02-03 ajouts images conf esp32
2025-02-10 ajout git log de simon bressot
2025-02-25 correction du code arduino pour que le capteur de température marche avec la heltech lora V3 (1 seul capteur et data sur gpio7)
    [controle_all_esp32.ino]
2025-02-25 Update Journal de bord Melilla
    help ppt
2025-02-28 code détection adresse data température; dans all: mesure en i2c de tension et courrant
2025-04-07 Create Essai de l'INA + algo poursuite du mpp
2025-04-07 essaye de résoudre problème pwm
2025-04-11 Update Essai de l'INA + algo poursuite du mpp
2025-05-15 PCB maj avec gerbber et dril & schematic & bom à jour
    [Altium_PCB.PrjPcb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]
